siyexue/Smart-desk-lamp/Smart desk lamp.ioc

Mcu.UserName=STM32F103C8Tx
PA1.Signal=ADCx_IN1
PA10.Signal=USART1_RX
PA13.Signal=SYS_JTMS-SWDIO
PA14.Signal=SYS_JTCK-SWCLK
PA4.GPIO_Label=TRIG
PA4.Signal=GPIO_Output
PA5.GPIO_Label=ECHO
PA5.Signal=GPIO_Input
PA6.Signal=S_TIM3_CH1
PA9.Signal=USART1_TX
PB12.GPIO_Label=LED1
PB12.Signal=GPIO_Output
PB13.GPIO_Label=buzzer
PB13.Signal=GPIO_Output
PB15.GPIO_Label=key
PB15.Signal=GPIO_Input
PB8.GPIO_Label=OLED_SCL
PB8.Signal=GPIO_Output
PB9.GPIO_Label=OLED_SDA
PB9.Signal=GPIO_Output
PC14-OSC32_IN.Signal=RCC_OSC32_IN
PC15-OSC32_OUT.Signal=RCC_OSC32_OUT
PD0-OSC_IN.Signal=RCC_OSC_IN
PD1-OSC_OUT.Signal=RCC_OSC_OUT
