siyexue/Smart-desk-lamp/Core/Inc/main.h

#define TRIG_Pin GPIO_PIN_4
#define TRIG_GPIO_Port GPIOA
#define ECHO_Pin GPIO_PIN_0
#define ECHO_GPIO_Port GPIOA
#define LED1_Pin GPIO_PIN_12
#define LED1_GPIO_Port GPIOB
#define buzzer_Pin GPIO_PIN_13
#define buzzer_GPIO_Port GPIOB
#define key_Pin GPIO_PIN_15
#define key_GPIO_Port GPIOB
#define OLED_SCL_Pin GPIO_PIN_8
#define OLED_SCL_GPIO_Port GPIOB
#define OLED_SDA_Pin GPIO_PIN_9
#define OLED_SDA_GPIO_Port GPIOB
