siyexue/Smart-desk-lamp/(commit log)

2026-06-06 初版：智能台灯项目初始化
    - Board: OLED, 蓝牙, HC-SR04, 蜂鸣器, 姿势检测, 疲劳检测
    - Core: main, ADC, GPIO, TIM, USART 配置
    - Drivers: STM32F1xx HAL 库 + CMSIS
    - MDK-ARM: Keil 项目文件 + startup 启动代码
    - CubeMX 配置 (.ioc)
2026-06-06 完善README以及工程手册内容
2026-06-06 修改readme.md
2026-06-06 doce:修正定时器频率来源
